gmitio/soundstage_design_workshop/Assembly/SoundstageFXPedal_V1_Assembly_BoM.xlsx

Reference | Value | Component
C201,C202 | 47uF | MOUSER: 232-63PK47MEFC6.3X11
C203,C204,C302,C303,C304,C408,C409 | 100uF | MOUSER: 232-25PX100MEFC5X11
C205,C206,C207,C305,C306,C401 | 100pF | MOUSER: 810-FG18C0G1H101JNT0
C301 | 1nF | MOUSER: 810-FG28C0G1H102JNT6
C307 | 47uF | MOUSER: 232-25PK47MEFC5X11
C402,C501 | 0.033uF | MOUSER: 810-FG14C0G1H333JNT6
C403 | 1500pF | MOUSER: 810-FG28C0G1H152JNT6
C404 | 0.22uF | MOUSER: 810-FG14X7R1H224KNT0
C405,C407,C410 | 10uF | MOUSER: 667-EEA-FC1E100
C406 | 0.015uF | MOUSER: 594-K153K15X7RF53L2
C502 | 0.047uF | MOUSER: 810-FG18X7R1H473KNT6
C701,C703 | 2.2uF | MOUSER: 667-ECA-1HM2R2
C702 | 0.01uF | MOUSER: 810-FG28C0G1H103JNT6
D101,D102 | 1N5819 | MOUSER: 637-1N5819
D301,D302 | 1N4148 | MOUSER: 512-1N4148
D401,D402 | LED | MOUSER: 606-4304H1
D403 | BAR43S | MOUSER: 511-BAR43SFILM
J101 | JST XH-B4B | MOUSER: 306-B4BXHALFSN
J102 | Barrel_Jack | MOUSER: 710-694106301002
J103 | BATT_CONN | MOUSER: 534-235
J105,J201,J202,RV301,RV401,RV402,RV501,RV502,RV701,RV702 | -- mixed values -- | MOUSER: 306-B3BXHALFSNP
J601,J602 | Conn_01x02_Pin
Q301,Q302 | 2N3906 | MOUSER: 637-2N3906
Q401 | 2N5457 | https://stompboxparts.com/semiconductors/2n5457-jfet/
Q701,Q702 | BC109 | MOUSER: 610-BC109C-TL
R201,R203,R405,R409,R506 | 10k | MOUSER: 603-MFR-25FTF52-10K
R202 | 820R | MOUSER: 603-MFR-25FBF52-820R
R204,R207 | 3.9k | MOUSER: 603-MFR-25FBF52-3K9
R205,R206 | 560R | MOUSER: 603-MFR-25FBF52-560R
R208,R301 | 3.3k | MOUSER: 603-MFR-25FRF52-3K3
R209,R210,R302,R303,R414 | 47k | MOUSER: 603-MFR-25FBF52-47K
R304,R305 | 4.7k | MOUSER: 603-MFR-25FTF52-4K7
R306,R307,R505 | 15k | MOUSER: 603-MFR-25FRF5215K
R308 | 33R | MOUSER: 603-MFR-25FBF52-33R
R309,R310,R501,R504 | 22k | MOUSER: 603-MFR-25FTF52-22K
R401,R415 | 200R | MOUSER: 603-MFR-25FBF52-200R
R402,R403,R404,R410,R412 | 1Meg | MOUSER: 603-MFR-25FTF52-1M
R406,R413 | 39k | MOUSER: 603-MFR-25FBF52-39K
R407,R411 | 22R | MOUSER: 603-MFR-25FBF52-22R
R408 | 5.1k | MOUSER: 603-MFR-25FBF52-5K1
R503 | 220k | MOUSER: 603-MFR-25FBF52-220K
R507 | 1k | MOUSER: 603-MFR-25FBF52-1K
R701 | 8.2k | MOUSER: 603-MFR-25FBF52-8K2
R702 | 330R | MOUSER: 603-MFR-25FTF52-330R
R703 | 33k | MOUSER: 603-MFR-25FBF52-33K
R704 | 100k | MOUSER: 708-RNF14FTD100K
SW201 | SW_DPDT_x2 | MOUSER: 306-B6BXHALFSN
U301,U401,U501 | TL072 | MOUSER: 595-TL072CP
