gmitio/soundstage_design_workshop/Assembly/SoundstageFXPedal_V1_Assembly_Drawing_Updated.pdf

# Assembly Drawing (Top View)

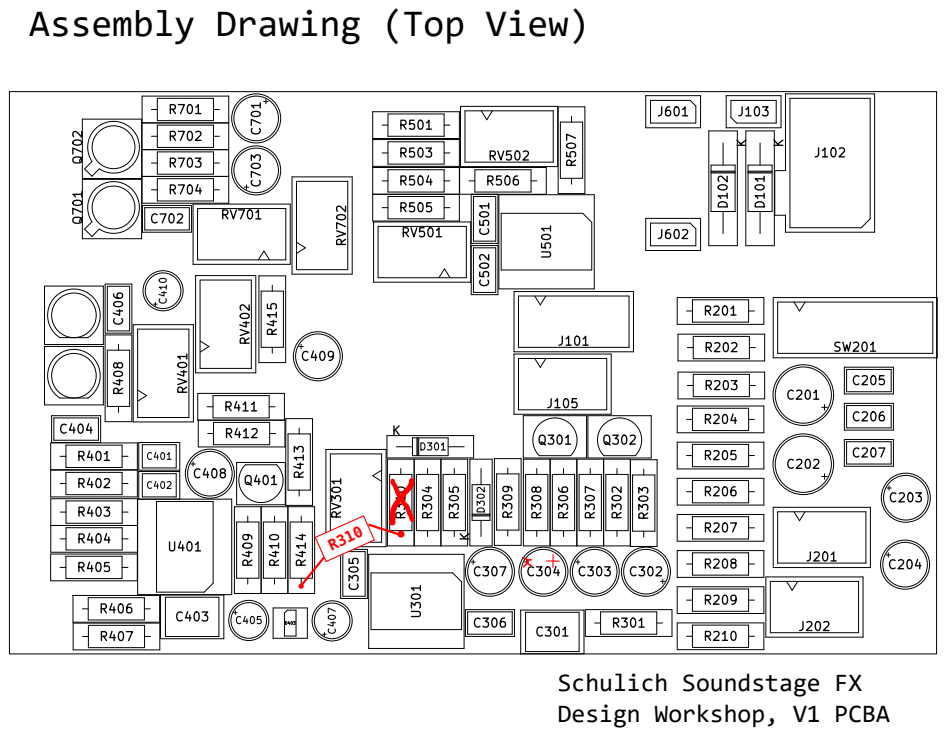
[picture p1: page 1]
