gmitio/soundstage_design_workshop/Schematic/SoundstageFXPedal_V1.pdf

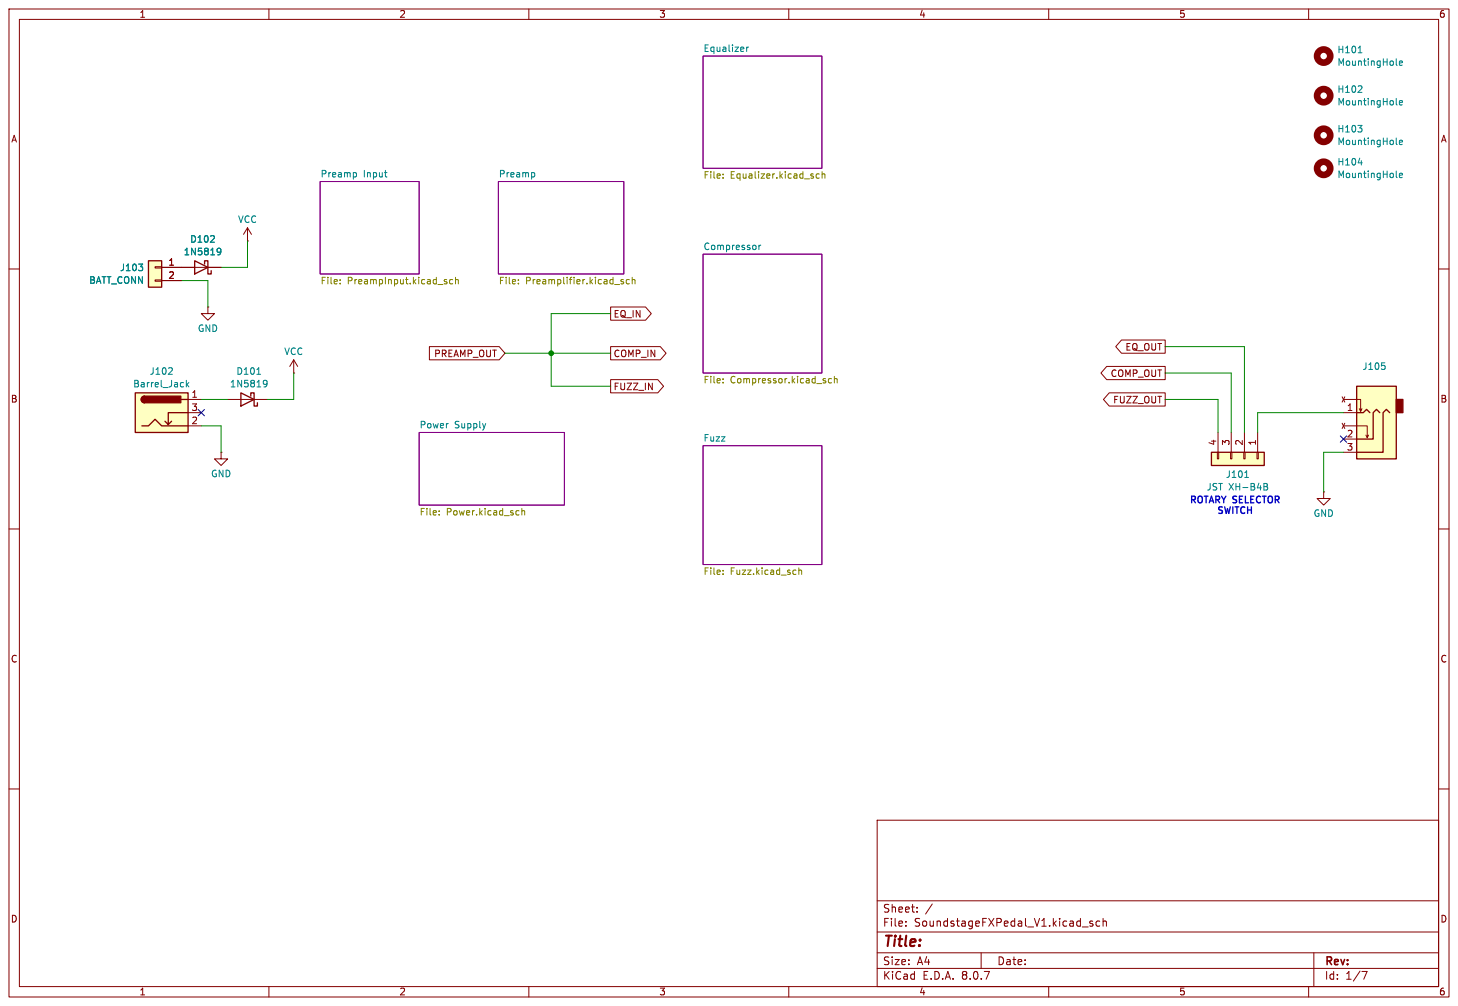
[picture p2: page 1]

J105 H102 MountingHole H101 MountingHole H103 MountingHole VCC

Compressor File: Compressor.kicad_sch Power Supply File: Power.kicad_sch Preamp File: Preamplifier.kicad_sch

Id: 1/7 Title: File: SoundstageFXPedal_V1.kicad_sch Sheet: /

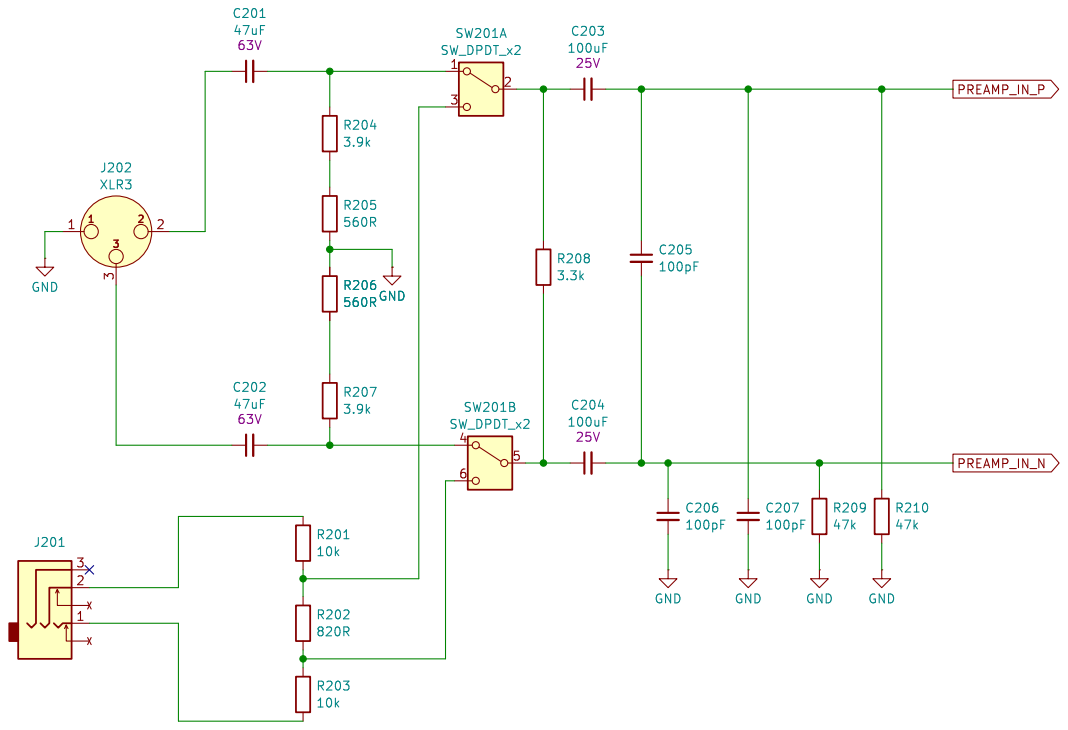
[picture p3: page 2]

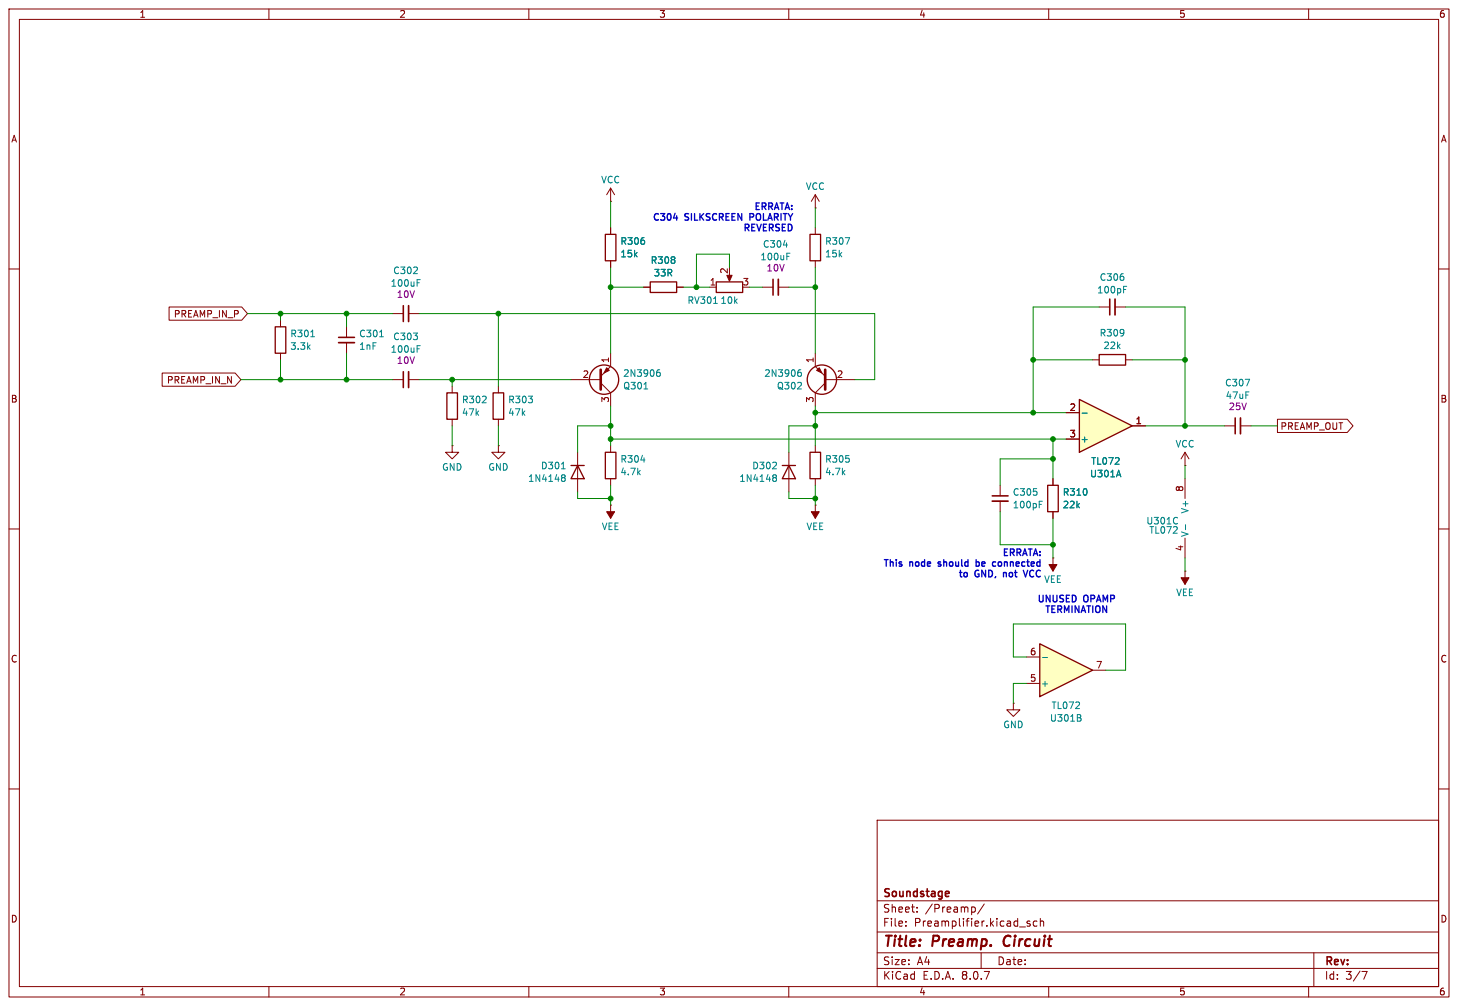
[picture p4: page 3]

ERRATA: C304 SILKSCREEN POLARITY REVERSED

PREAMP_OUT ERRATA: This node should be connected

to GND, not VCC

Id: 3/7 Title: Preamp. Circuit File: Preamplifier.kicad_sch Sheet: /Preamp/

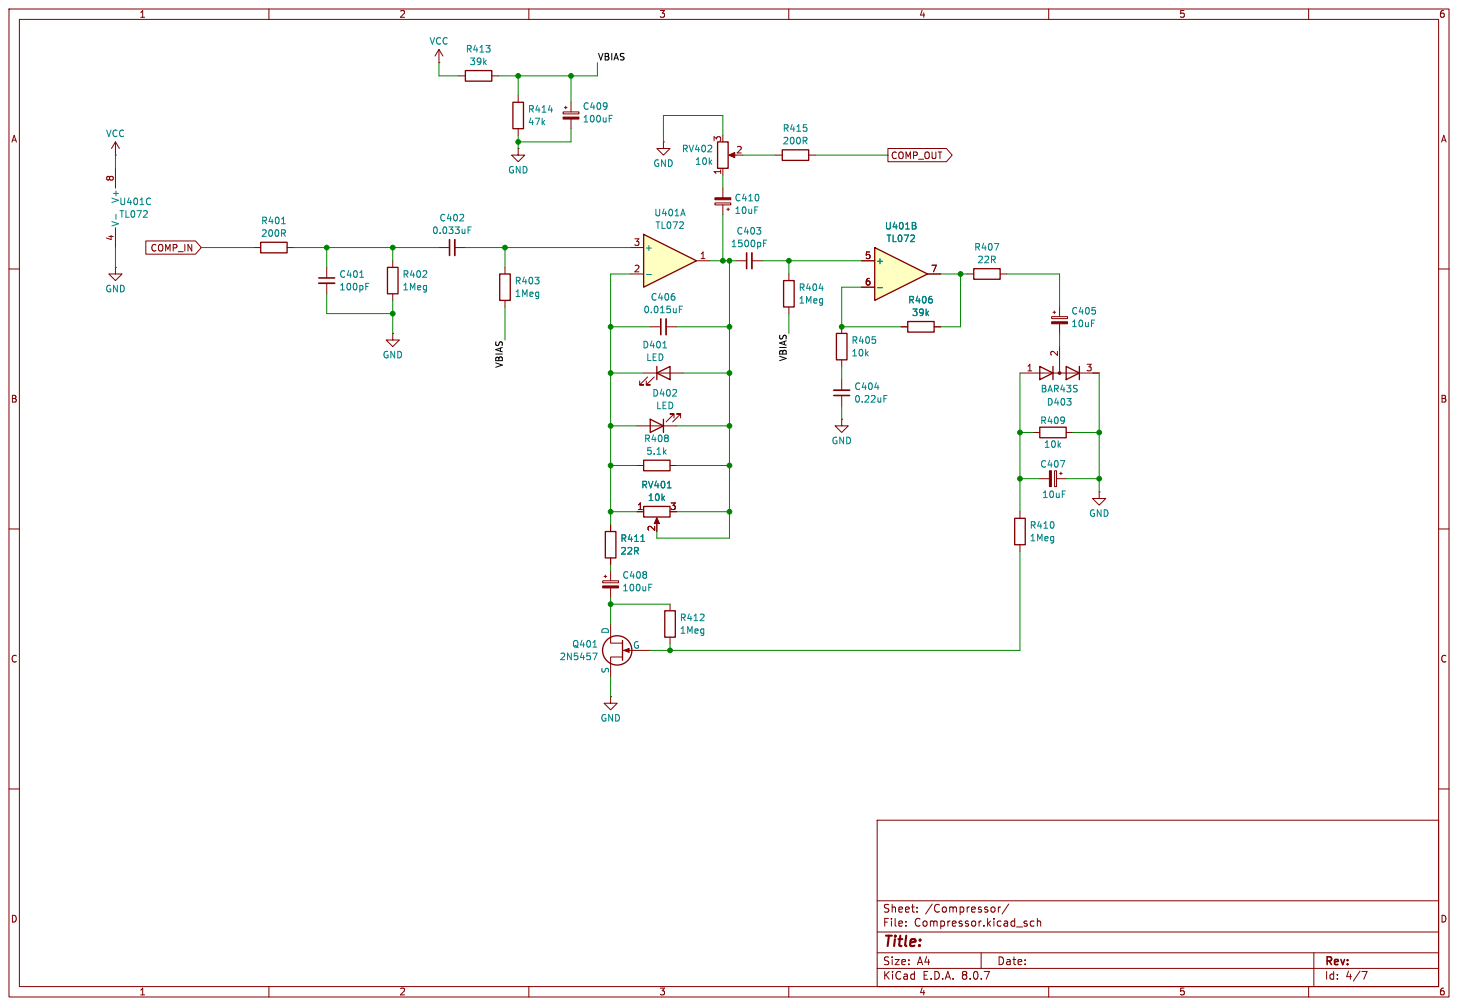
[picture p5: page 4]

Id: 4/7 Title: File: Compressor.kicad_sch Sheet: /Compressor/

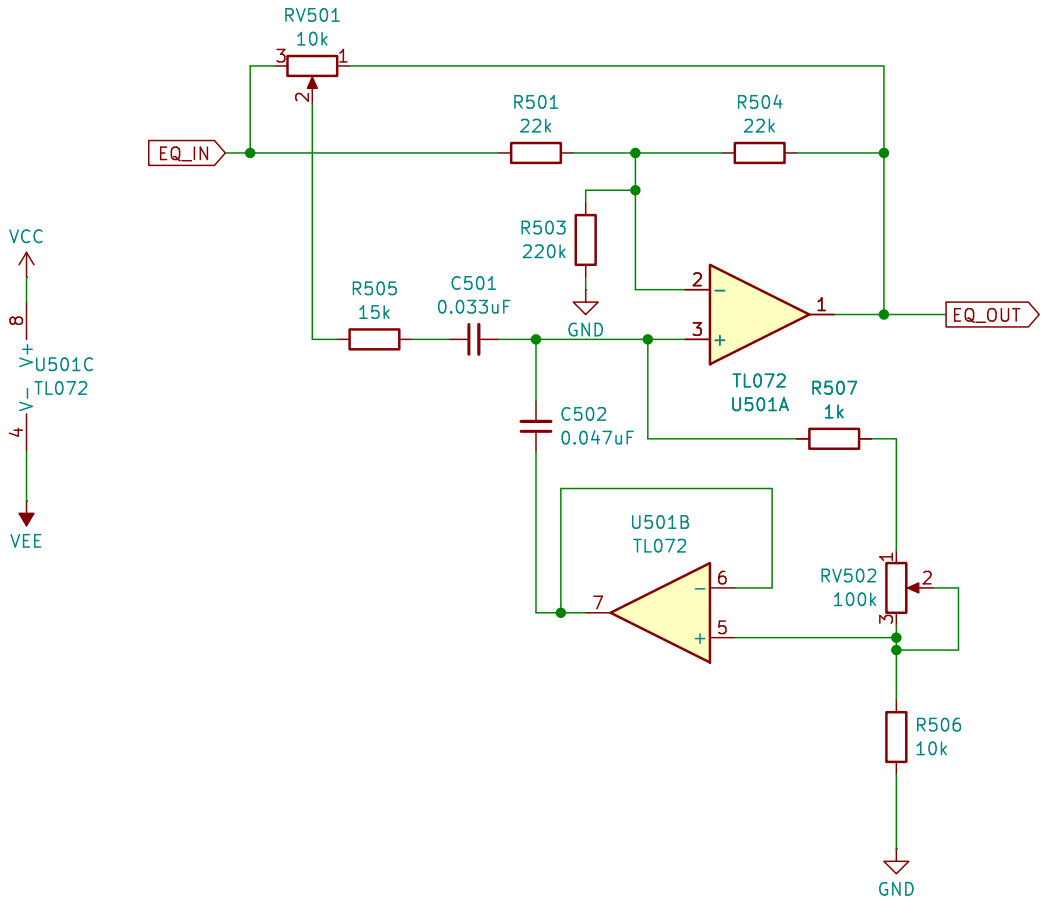
[picture p6: page 5]

Id: 5/7 Title: File: Equalizer.kicad_sch Sheet: /Equalizer/

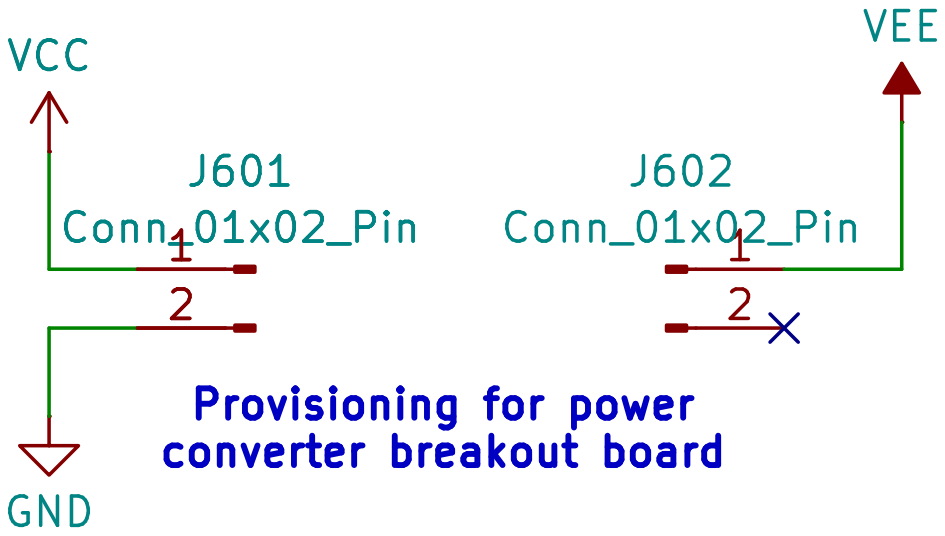
[picture p7: page 6]

J602 Conn_01x02_Pin Provisioning for power converter breakout board VCC

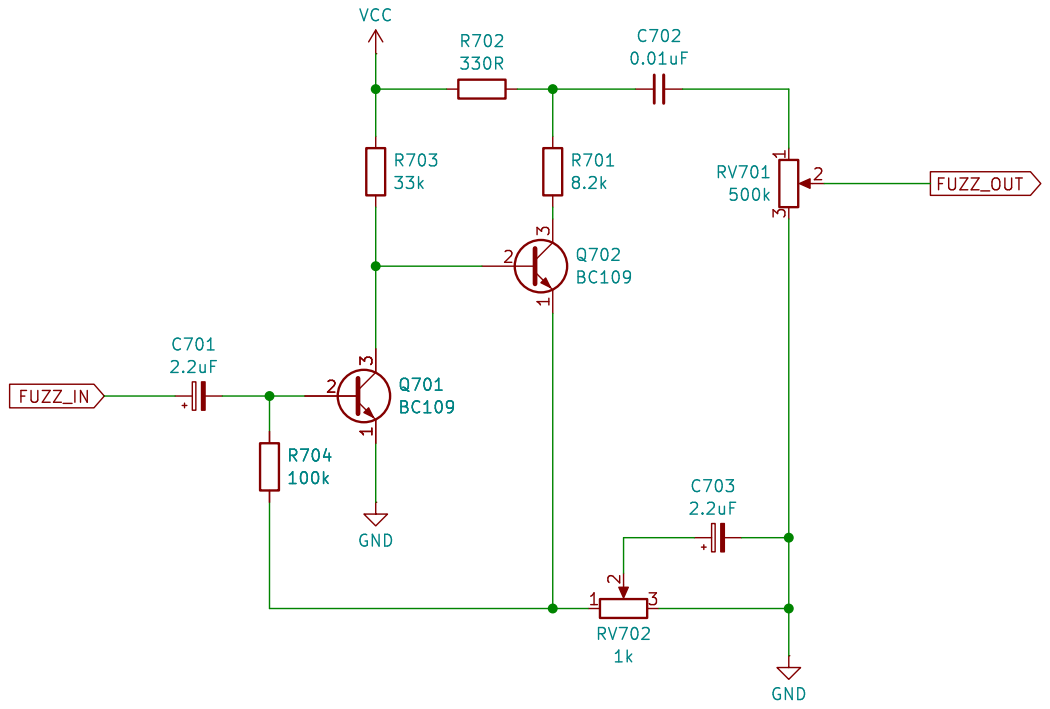
[picture p8: page 7]

Id: 7/7 Title: File: Fuzz.kicad_sch Sheet: /Fuzz/ GND
