gmitio/soundstage_design_workshop/Resources/Switchcraft_N112BPCX.pdf

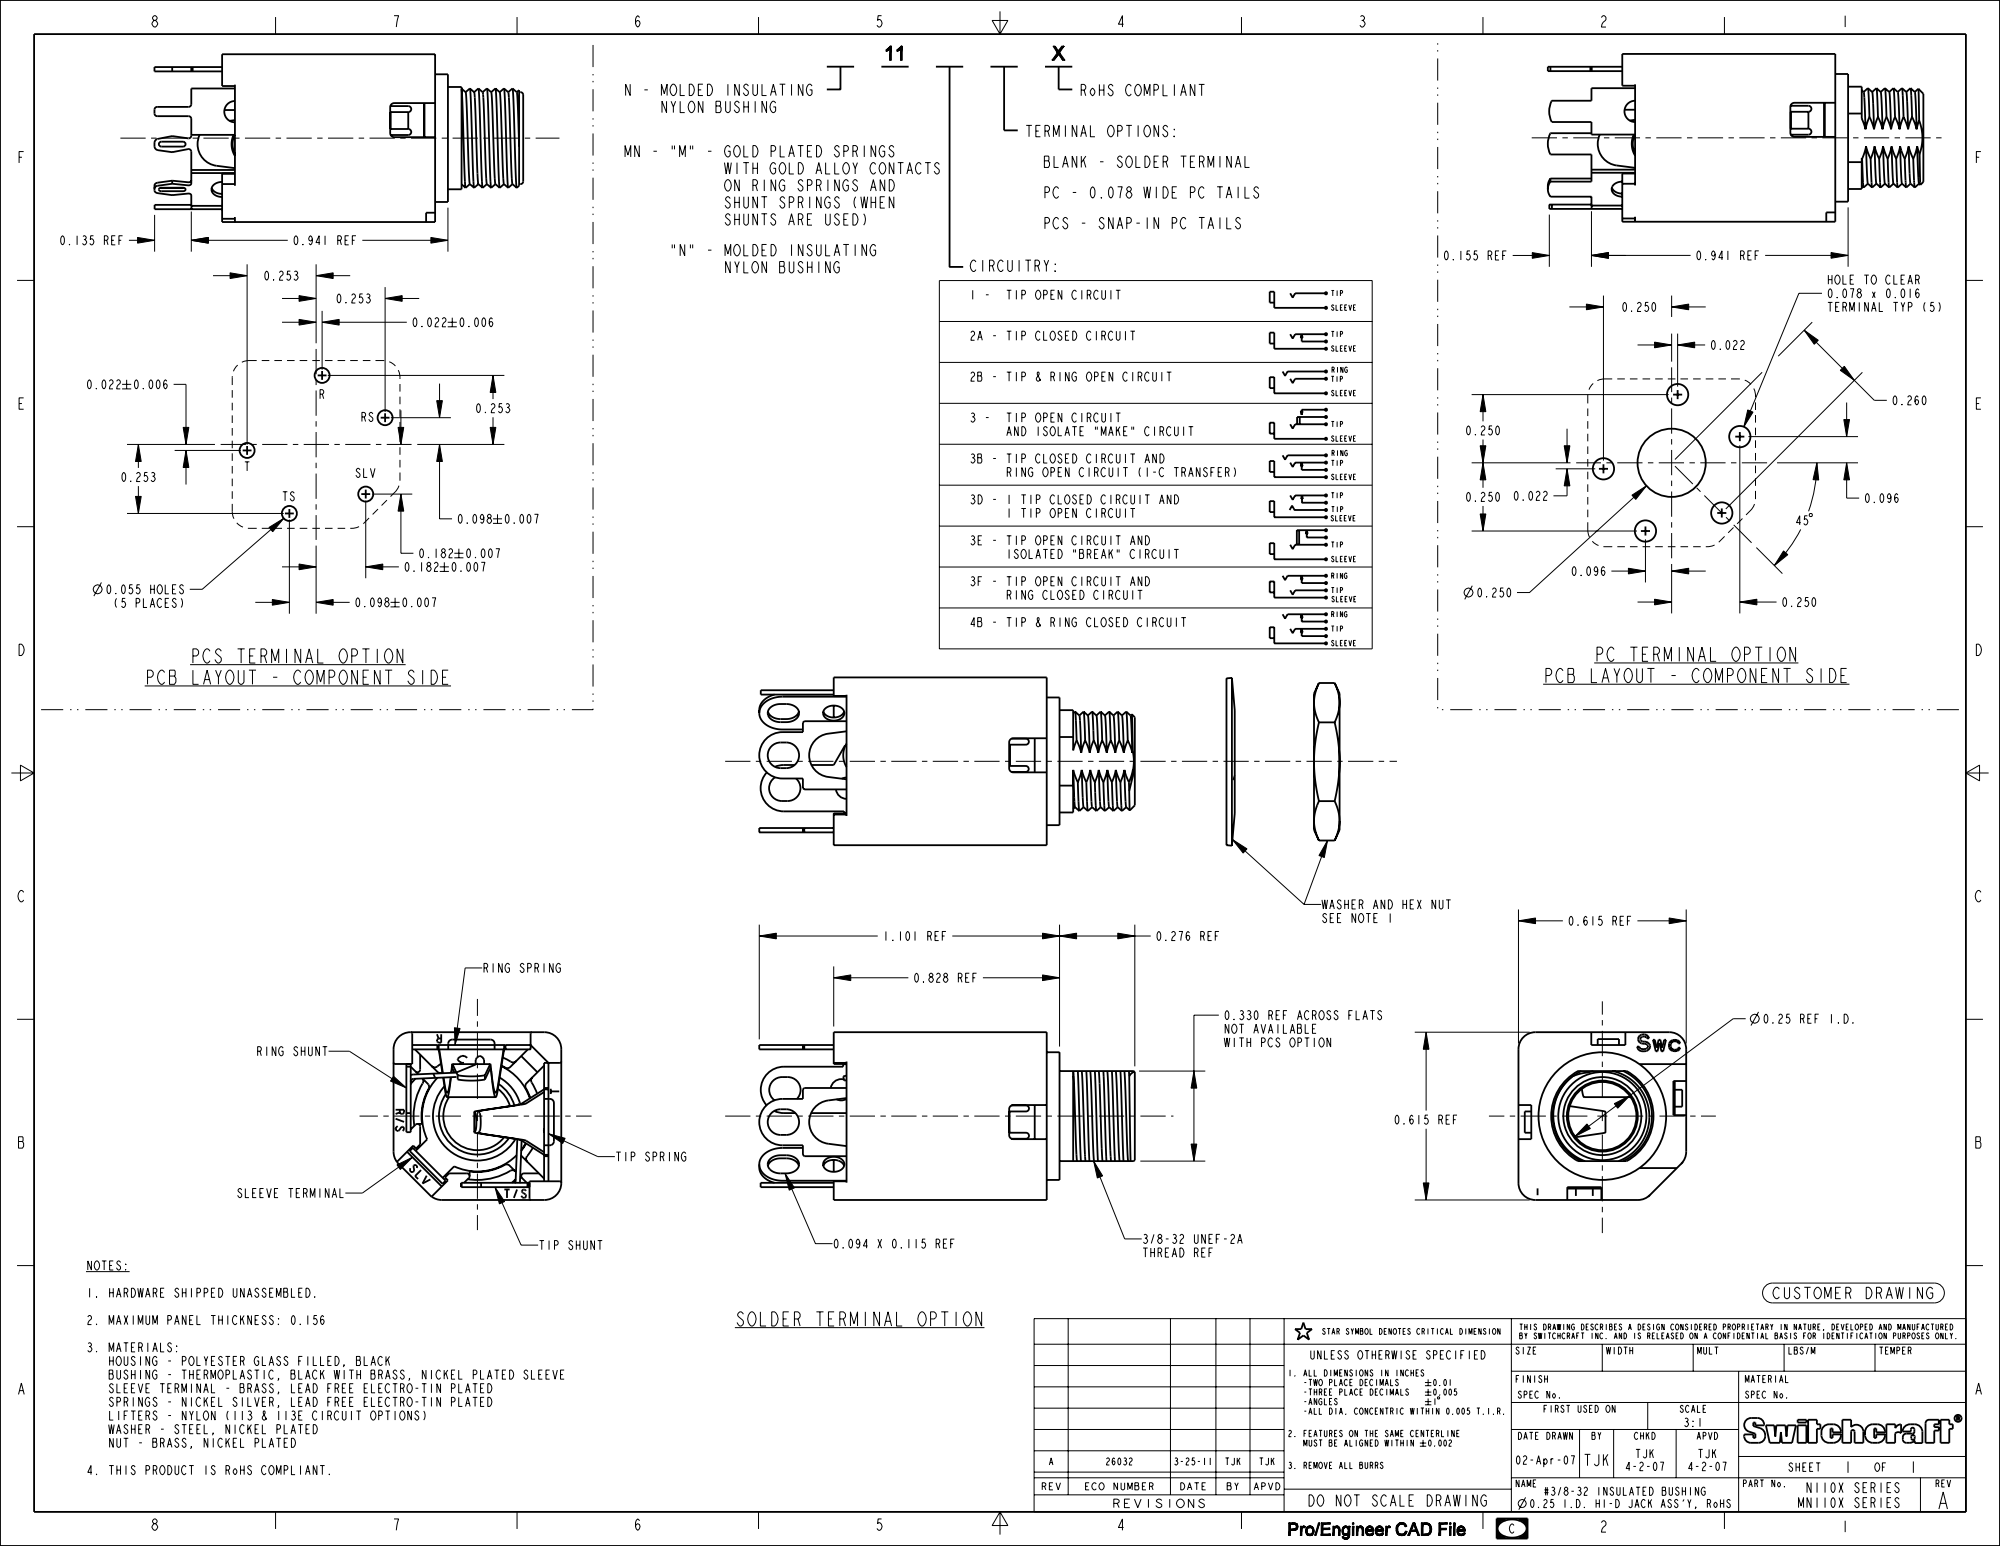
[picture p9: page 1]
