gmitio/soundstage_design_workshop/SoundstageFXPedal_V1.kicad_pcb

## KiCad design SoundstageFXPedal_V1.kicad_pcb (2025-01-26)

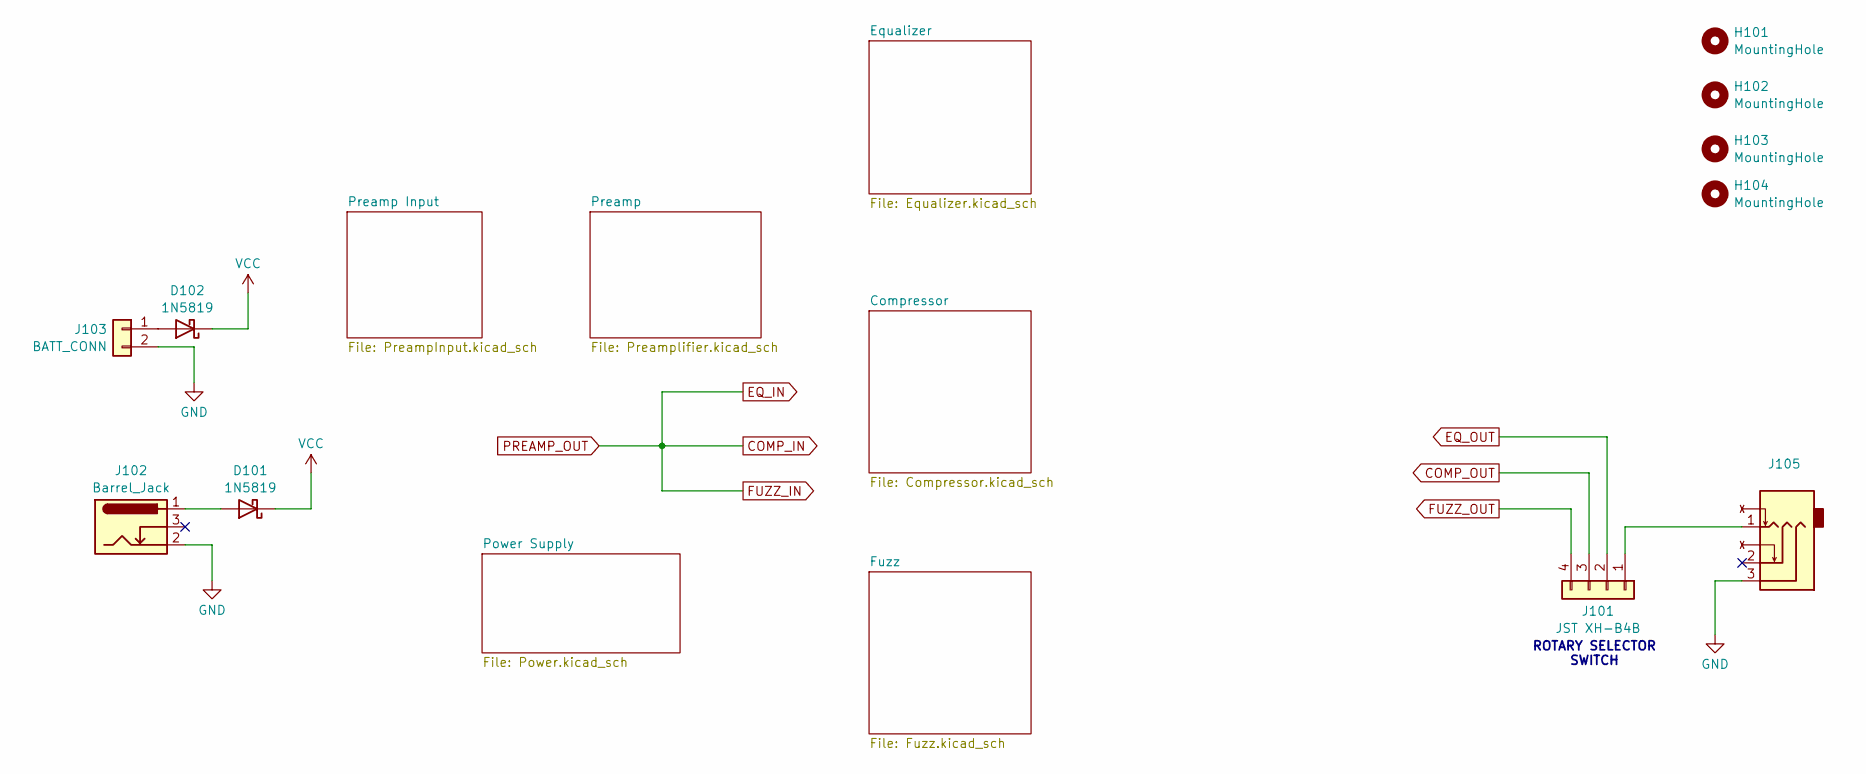
[picture p10: schematic SoundstageFXPedal_V1.kicad_sch]

Parts:
D101, D102: 1N5819; D_DO-41_SOD81_P10.16mm_Horizontal
H101, H102, H103, H104: MountingHole; MountingHole_4.3mm_M4_DIN965
J101: JST XH-B4B; JST_XH_B4B-XH-A_1x04_P2.50mm_Vertical
J102: Barrel_Jack; BarrelJack_Wuerth_6941xx301002
J103: BATT_CONN; PinHeader_1x02_P2.54mm_Vertical
J105: JST_XH_B3B-XH-A_1x03_P2.50mm_Vertical

Connections:
COMP_OUT: J101.3; also elsewhere on the board
EQ_OUT: J101.2; also elsewhere on the board
FUZZ_OUT: J101.4; also elsewhere on the board
GND: J102.2, J103.2, J105.3; also elsewhere on the board
unnamed: D101.2 (A), J102.1
unnamed: D102.2 (A), J103.1
unnamed: J101.1, J105.1
VCC: D101.1 (K), D102.1 (K); also elsewhere on the board

Notes on the sheet:
ROTARY SELECTOR SWITCH

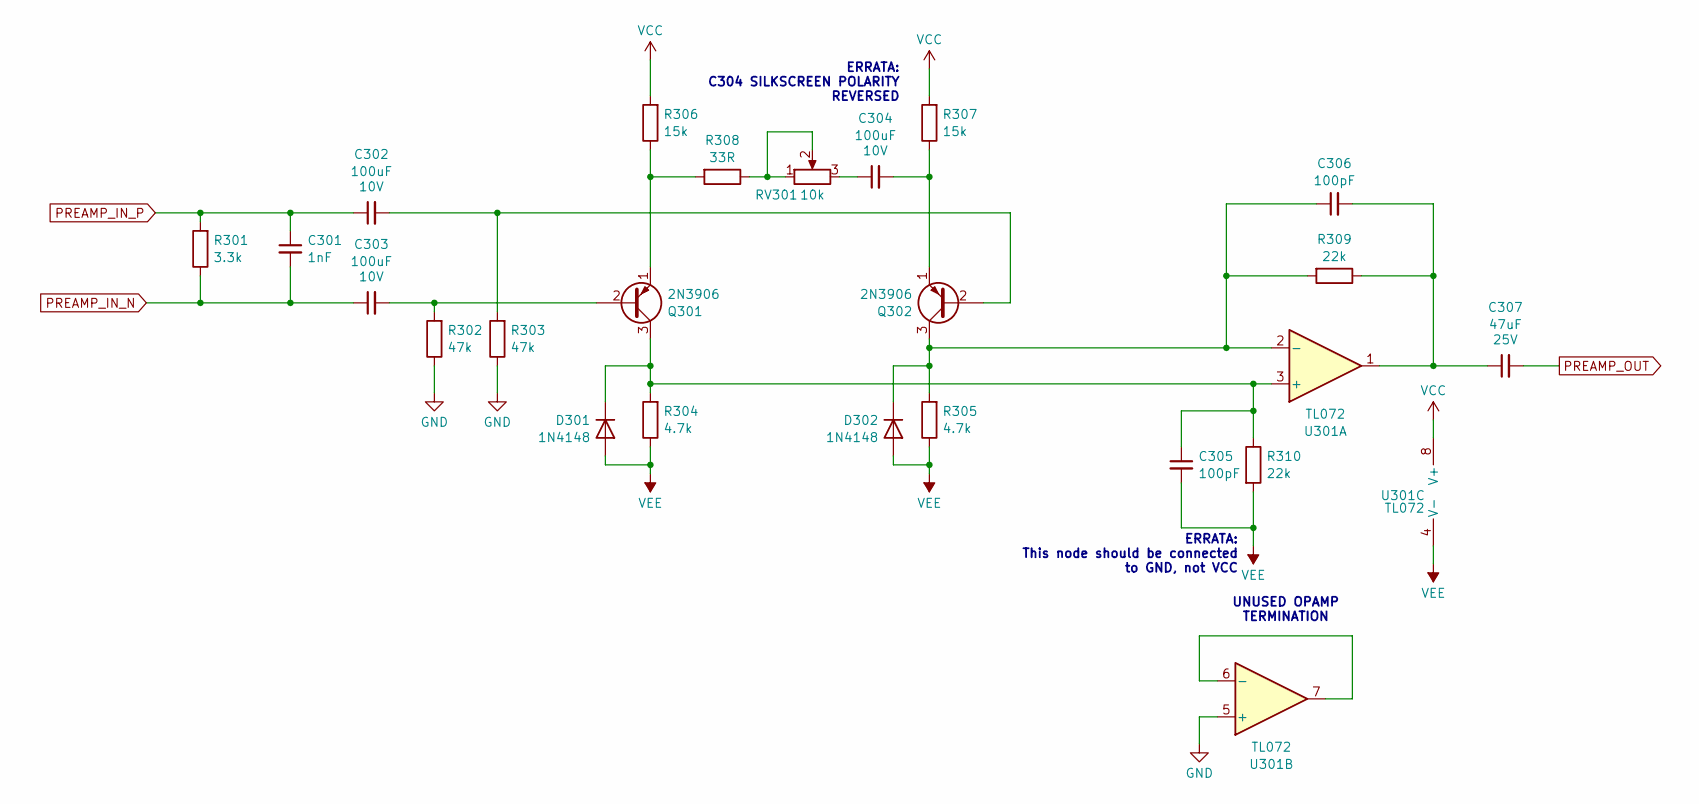
[picture p11: schematic Preamplifier.kicad_sch, Preamp. Circuit]

Parts:
C301: 1nF; C_Disc_D6.0mm_W4.4mm_P5.00mm
C302, C303, C304: 100uF; CP_Radial_D5.0mm_P2.00mm; Voltage 10V
C305, C306: 100pF; C_Disc_D5.0mm_W2.5mm_P2.50mm
C307: 47uF; CP_Radial_D5.0mm_P2.00mm; Voltage 25V; PartNo. MOUSER: 232-25PK47MEFC5X11
D301, D302: 1N4148; D_DO-35_SOD27_P7.62mm_Horizontal
Q301, Q302: 2N3906; TO-92_Inline_Wide
R301: 3.3k; R_Axial_DIN0207_L6.3mm_D2.5mm_P7.62mm_Horizontal
R302, R303: 47k; R_Axial_DIN0207_L6.3mm_D2.5mm_P7.62mm_Horizontal
R304, R305: 4.7k; R_Axial_DIN0207_L6.3mm_D2.5mm_P7.62mm_Horizontal
R306, R307: 15k; R_Axial_DIN0207_L6.3mm_D2.5mm_P7.62mm_Horizontal
R308: 33R; R_Axial_DIN0207_L6.3mm_D2.5mm_P7.62mm_Horizontal
R309, R310: 22k; R_Axial_DIN0207_L6.3mm_D2.5mm_P7.62mm_Horizontal
RV301: 10k; JST_XH_B3B-XH-A_1x03_P2.50mm_Vertical
U301: TL072; DIP-8_W7.62mm_LongPads

Connections:
GND: R302.1, R303.1, U301.5 (+); also elsewhere on the board
unnamed: C304.1, RV301.3
unnamed: C306.2, C307.1, R309.1, U301.1
unnamed: C305.1, D301.1 (K), Q301.3 (C), R304.2, R310.1, U301.3 (+)
unnamed: C306.1, D302.1 (K), Q302.3 (C), R305.2, R309.2, U301.2 (-)
unnamed: C303.2, Q301.2 (B), R302.2
unnamed: Q301.1 (E), R306.1, R308.2
unnamed: C302.2, Q302.2 (B), R303.2
unnamed: C304.2, Q302.1 (E), R307.1
unnamed: R308.1, RV301.1, RV301.2
unnamed: U301.6 (-), U301.7
PREAMP_IN_N: C301.2, C303.1, R301.1; also elsewhere on the board
PREAMP_IN_P: C301.1, C302.1, R301.2; also elsewhere on the board
VCC: R306.2, R307.2, U301.8 (V+); also elsewhere on the board
VEE: C305.2, D301.2 (A), D302.2 (A), R304.1, R305.1, R310.2, U301.4 (V-); also elsewhere on the board

Notes on the sheet:
ERRATA: This node should be connected to GND, not VCC
UNUSED OPAMP TERMINATION
ERRATA: C304 SILKSCREEN POLARITY REVERSED

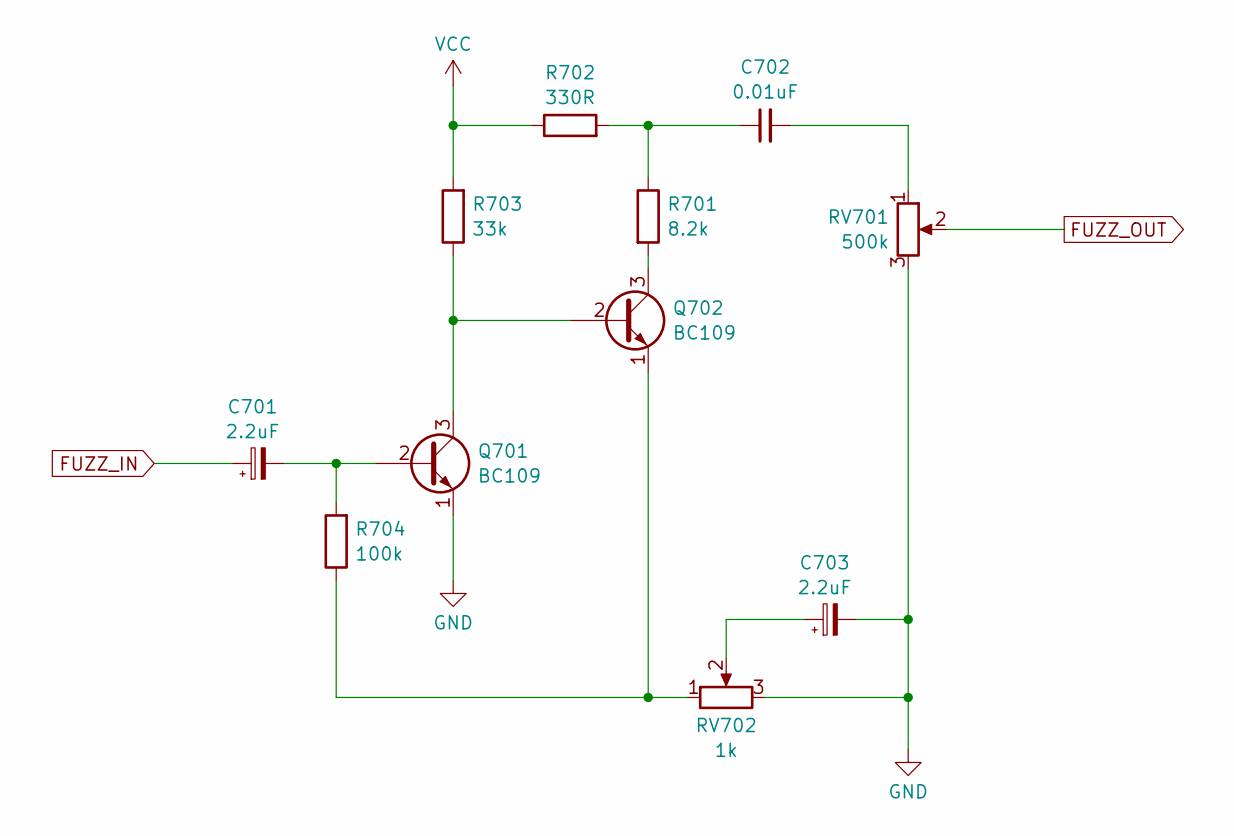
[picture p12: schematic Fuzz.kicad_sch]

Parts:
C701, C703: 2.2uF; CP_Radial_D5.0mm_P2.00mm
C702: 0.01uF; C_Disc_D5.0mm_W2.5mm_P2.50mm
Q701, Q702: BC109; TO-18-3
R701: 8.2k; R_Axial_DIN0207_L6.3mm_D2.5mm_P7.62mm_Horizontal
R702: 330R; R_Axial_DIN0207_L6.3mm_D2.5mm_P7.62mm_Horizontal
R703: 33k; R_Axial_DIN0207_L6.3mm_D2.5mm_P7.62mm_Horizontal
R704: 100k; R_Axial_DIN0207_L6.3mm_D2.5mm_P7.62mm_Horizontal
RV701: 500k; JST_XH_B3B-XH-A_1x03_P2.50mm_Vertical
RV702: 1k; JST_XH_B3B-XH-A_1x03_P2.50mm_Vertical

Connections:
FUZZ_OUT: RV701.2; also elsewhere on the board
GND: C703.2, Q701.1 (E), RV701.3, RV702.3; also elsewhere on the board
unnamed: C702.1, R701.1, R702.2
unnamed: C702.2, RV701.1
unnamed: C703.1, RV702.2
unnamed: C701.2, Q701.2 (B), R704.2
unnamed: Q701.3 (C), Q702.2 (B), R703.1
unnamed: Q702.3 (C), R701.2
unnamed: Q702.1 (E), R704.1, RV702.1
VCC: R702.1, R703.2; also elsewhere on the board

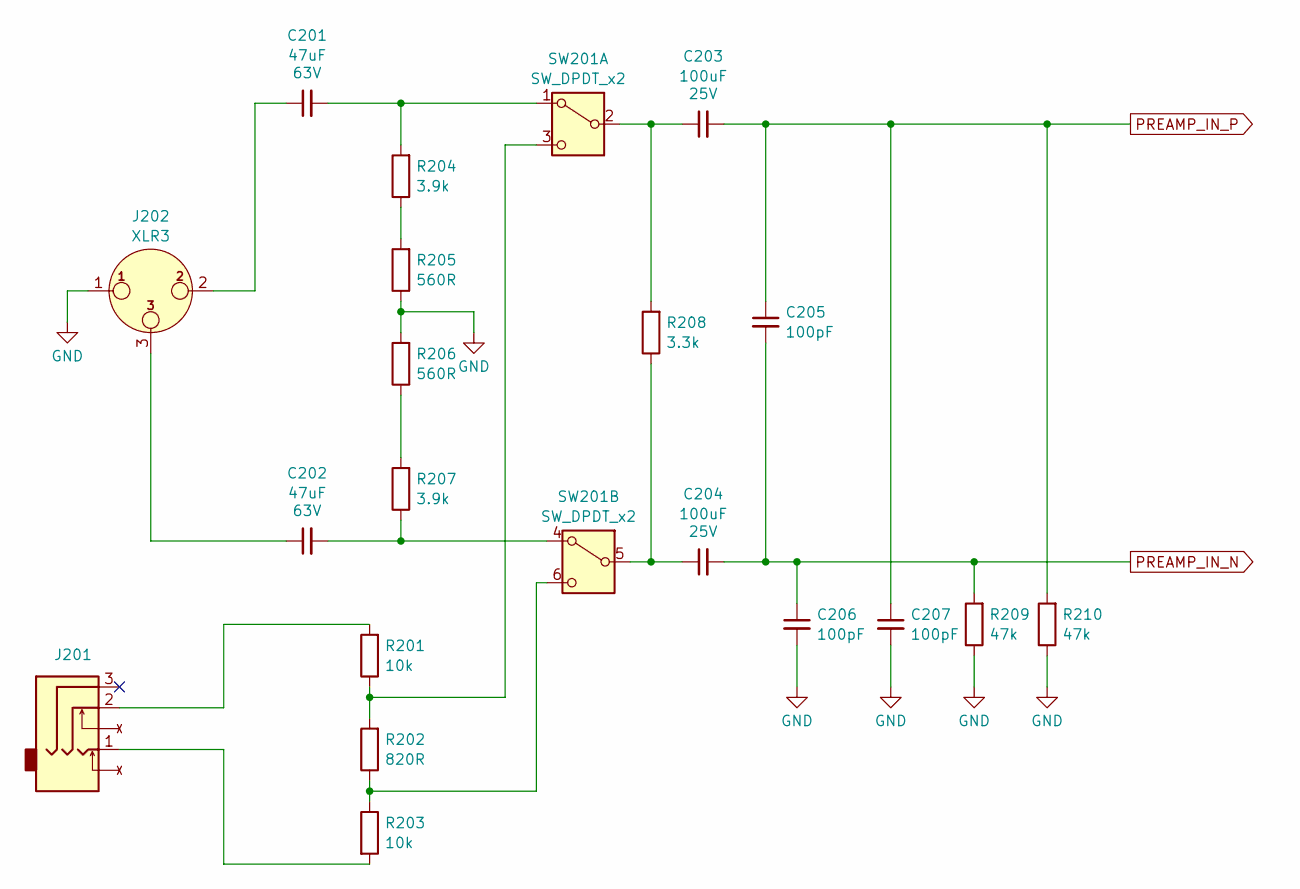
[picture p13: schematic PreampInput.kicad_sch, Preamp Input Circuit]

Parts:
C201, C202: 47uF; CP_Radial_D6.3mm_P2.50mm; Voltage 63V
C203, C204: 100uF; CP_Radial_D5.0mm_P2.00mm; Voltage 25V
C205, C206, C207: 100pF; C_Disc_D5.0mm_W2.5mm_P2.50mm
J201: JST_XH_B3B-XH-A_1x03_P2.50mm_Vertical
J202: XLR3; JST_XH_B3B-XH-A_1x03_P2.50mm_Vertical
R201, R203: 10k; R_Axial_DIN0207_L6.3mm_D2.5mm_P7.62mm_Horizontal
R202: 820R; R_Axial_DIN0207_L6.3mm_D2.5mm_P7.62mm_Horizontal
R204, R207: 3.9k; R_Axial_DIN0207_L6.3mm_D2.5mm_P7.62mm_Horizontal
R205, R206: 560R; R_Axial_DIN0207_L6.3mm_D2.5mm_P7.62mm_Horizontal
R208: 3.3k; R_Axial_DIN0207_L6.3mm_D2.5mm_P7.62mm_Horizontal
R209, R210: 47k; R_Axial_DIN0207_L6.3mm_D2.5mm_P7.62mm_Horizontal
SW201: SW_DPDT_x2; JST_XH_B6B-XH-A_1x06_P2.50mm_Vertical

Connections:
GND: C206.2, C207.2, J202.1, R205.1, R206.2, R209.1, R210.1; also elsewhere on the board
unnamed: C201.1, J202.2
unnamed: C202.1, J202.3
unnamed: J201.1, R203.2
unnamed: J201.2, R201.2
unnamed: R204.1, R205.2
unnamed: R206.1, R207.2
unnamed: C201.2, R204.2, SW201.1 (A)
unnamed: C203.1, R208.2, SW201.2 (B)
unnamed: R201.1, R202.2, SW201.3 (C)
unnamed: C202.2, R207.1, SW201.4 (A)
unnamed: C204.1, R208.1, SW201.5 (B)
unnamed: R202.1, R203.1, SW201.6 (C)
PREAMP_IN_N: C204.2, C205.2, C206.1, R209.2; also elsewhere on the board
PREAMP_IN_P: C203.2, C205.1, C207.1, R210.2; also elsewhere on the board

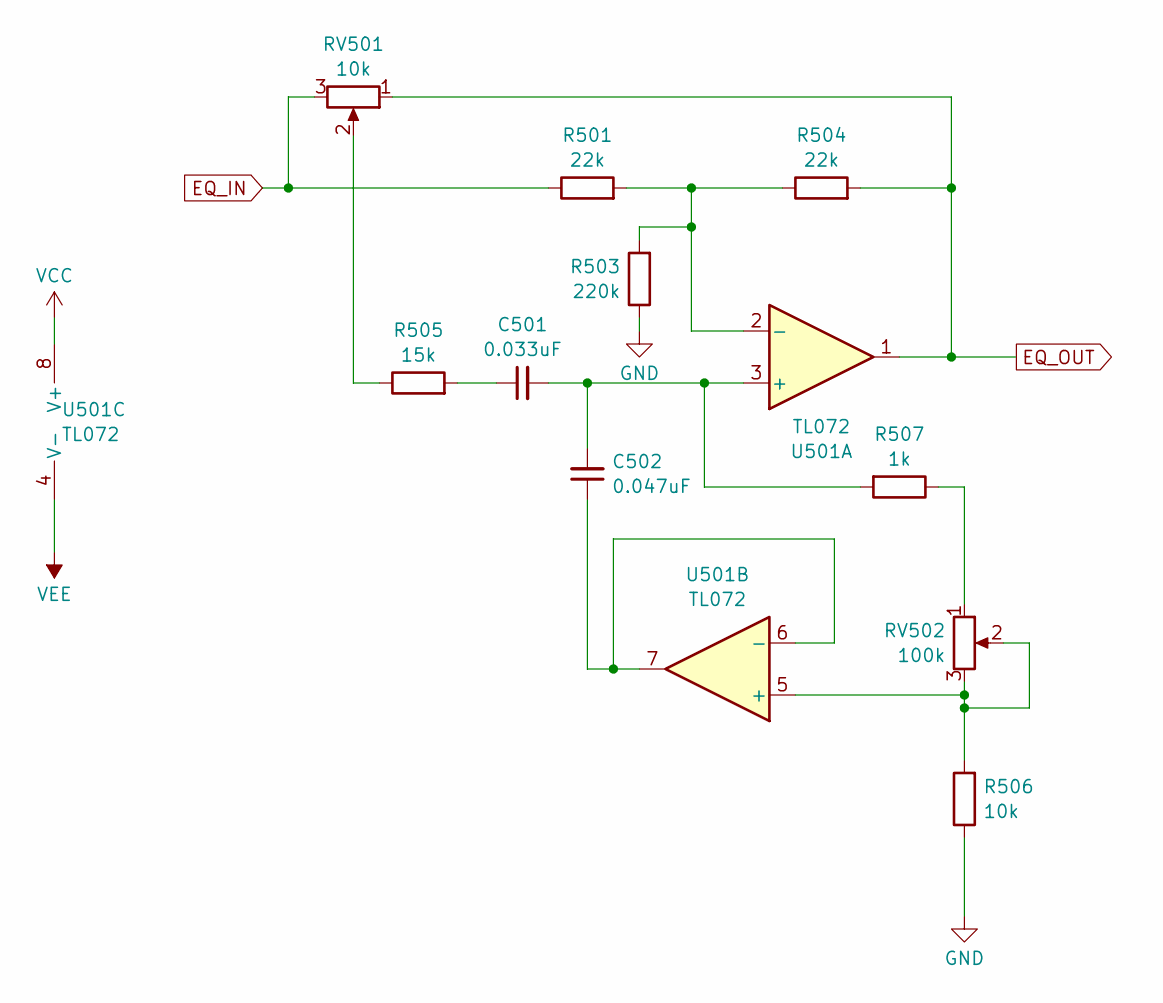
[picture p14: schematic Equalizer.kicad_sch]

Parts:
C501: 0.033uF; C_Disc_D5.0mm_W2.5mm_P2.50mm; PartNo. FG14C0G1H333JNT06
C502: 0.047uF; C_Disc_D5.0mm_W2.5mm_P2.50mm
R501, R504: 22k; R_Axial_DIN0207_L6.3mm_D2.5mm_P7.62mm_Horizontal
R503: 220k; R_Axial_DIN0207_L6.3mm_D2.5mm_P7.62mm_Horizontal
R505: 15k; R_Axial_DIN0207_L6.3mm_D2.5mm_P7.62mm_Horizontal
R506: 10k; R_Axial_DIN0207_L6.3mm_D2.5mm_P7.62mm_Horizontal
R507: 1k; R_Axial_DIN0207_L6.3mm_D2.5mm_P7.62mm_Horizontal
RV501: 10k; JST_XH_B3B-XH-A_1x03_P2.50mm_Vertical
RV502: 100k; JST_XH_B3B-XH-A_1x03_P2.50mm_Vertical
U501: TL072; DIP-8_W7.62mm_LongPads

Connections:
EQ_OUT: R504.2, RV501.1, U501.1; also elsewhere on the board
GND: R503.1, R506.1; also elsewhere on the board
unnamed: C501.1, R505.2
unnamed: R505.1, RV501.2
unnamed: R507.1, RV502.1
unnamed: C501.2, C502.2, R507.2, U501.3 (+)
unnamed: R501.2, R503.2, R504.1, U501.2 (-)
unnamed: R506.2, RV502.2, RV502.3, U501.5 (+)
unnamed: C502.1, U501.6 (-), U501.7
VCC: U501.8 (V+); also elsewhere on the board
VEE: U501.4 (V-); also elsewhere on the board

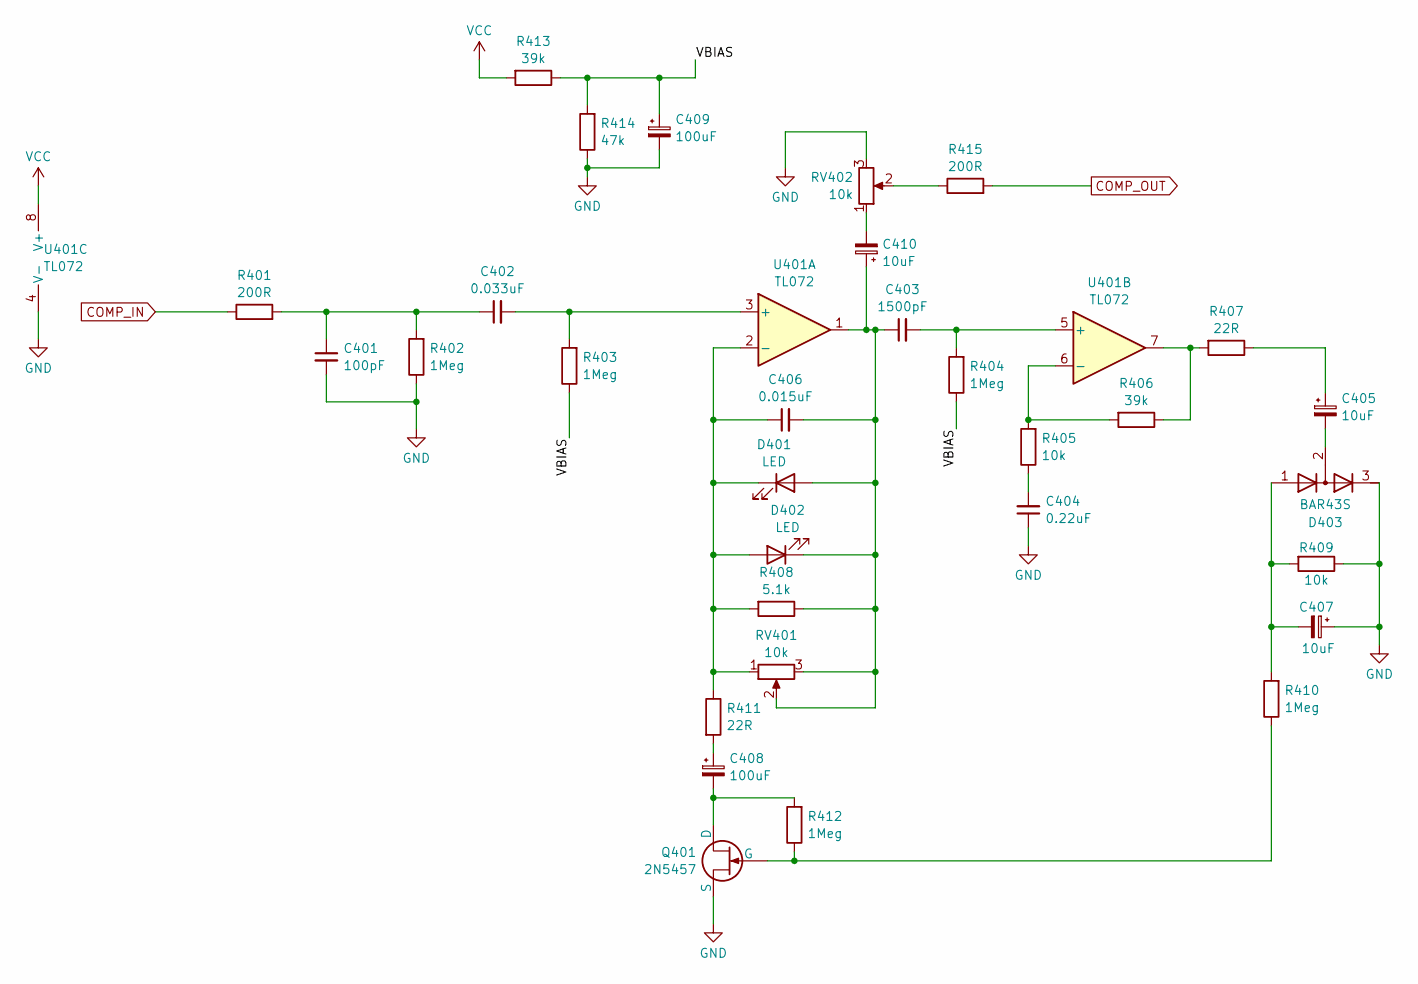
[picture p15: schematic Compressor.kicad_sch]

Parts:
C401: 100pF; C_Disc_D3.8mm_W2.6mm_P2.50mm; PartNo. FG18C0G1H101JNT06
C402: 0.033uF; C_Disc_D3.8mm_W2.6mm_P2.50mm; PartNo. FG14C0G1H333JNT06
C403: 1500pF; C_Disc_D6.0mm_W4.4mm_P5.00mm
C404: 0.22uF; C_Disc_D5.0mm_W2.5mm_P2.50mm
C405, C407, C410: 10uF; CP_Radial_D4.0mm_P1.50mm
C406: 0.015uF; C_Disc_D5.0mm_W2.5mm_P2.50mm
C408, C409: 100uF; CP_Radial_D5.0mm_P2.00mm
D401, D402: LED; LED_D5.0mm_FlatTop
D403: BAR43S; SOT-23; PartNo. BAR43SFILM
Q401: 2N5457; TO-92_Inline
R401, R415: 200R; R_Axial_DIN0207_L6.3mm_D2.5mm_P7.62mm_Horizontal
R402, R403, R404, R410, R412: 1Meg; R_Axial_DIN0207_L6.3mm_D2.5mm_P7.62mm_Horizontal
R405, R409: 10k; R_Axial_DIN0207_L6.3mm_D2.5mm_P7.62mm_Horizontal
R406, R413: 39k; R_Axial_DIN0207_L6.3mm_D2.5mm_P7.62mm_Horizontal
R407, R411: 22R; R_Axial_DIN0207_L6.3mm_D2.5mm_P7.62mm_Horizontal
R408: 5.1k; R_Axial_DIN0207_L6.3mm_D2.5mm_P7.62mm_Horizontal
R414: 47k; R_Axial_DIN0207_L6.3mm_D2.5mm_P7.62mm_Horizontal
RV401, RV402: 10k; JST_XH_B3B-XH-A_1x03_P2.50mm_Vertical
U401: TL072; DIP-8_W7.62mm_LongPads

Connections:
/Compressor/VBIAS: C409.1, R403.1, R404.1, R413.1, R414.2
COMP_OUT: R415.2; also elsewhere on the board
GND: C401.2, C404.1, C407.1, C409.2, D403.3 (K), Q401.3 (S), R402.1, R409.1, R414.1, RV402.3, U401.4 (V-); also elsewhere on the board
unnamed: C401.1, C402.1, R401.2, R402.2
unnamed: C404.2, R405.1
unnamed: C405.1, R407.1
unnamed: C405.2, D403.2
unnamed: C408.1, R411.2
unnamed: C410.2, RV402.1
unnamed: C403.1, C406.2, C410.1, D401.2 (A), D402.1 (K), R408.1, RV401.2, RV401.3, U401.1
unnamed: C406.1, D401.1 (K), D402.2 (A), R408.2, R411.1, RV401.1, U401.2 (-)
unnamed: C407.2, D403.1 (A), R409.2, R410.2
unnamed: C408.2, Q401.1 (D), R412.2
unnamed: Q401.2 (G), R410.1, R412.1
unnamed: R406.1, R407.2, U401.7
unnamed: R415.1, RV402.2
unnamed: C402.2, R403.2, U401.3 (+)
unnamed: C403.2, R404.2, U401.5 (+)
unnamed: R405.2, R406.2, U401.6 (-)
VCC: R413.2, U401.8 (V+); also elsewhere on the board

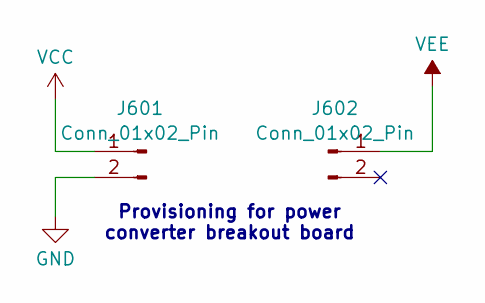
[picture p16: schematic Power.kicad_sch]

Parts:
J601, J602: Conn_01x02_Pin; PinHeader_1x02_P2.54mm_Vertical

Connections:
GND: J601.2; also elsewhere on the board
VCC: J601.1; also elsewhere on the board
VEE: J602.1; also elsewhere on the board

Notes on the sheet:
Provisioning for power converter breakout board

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
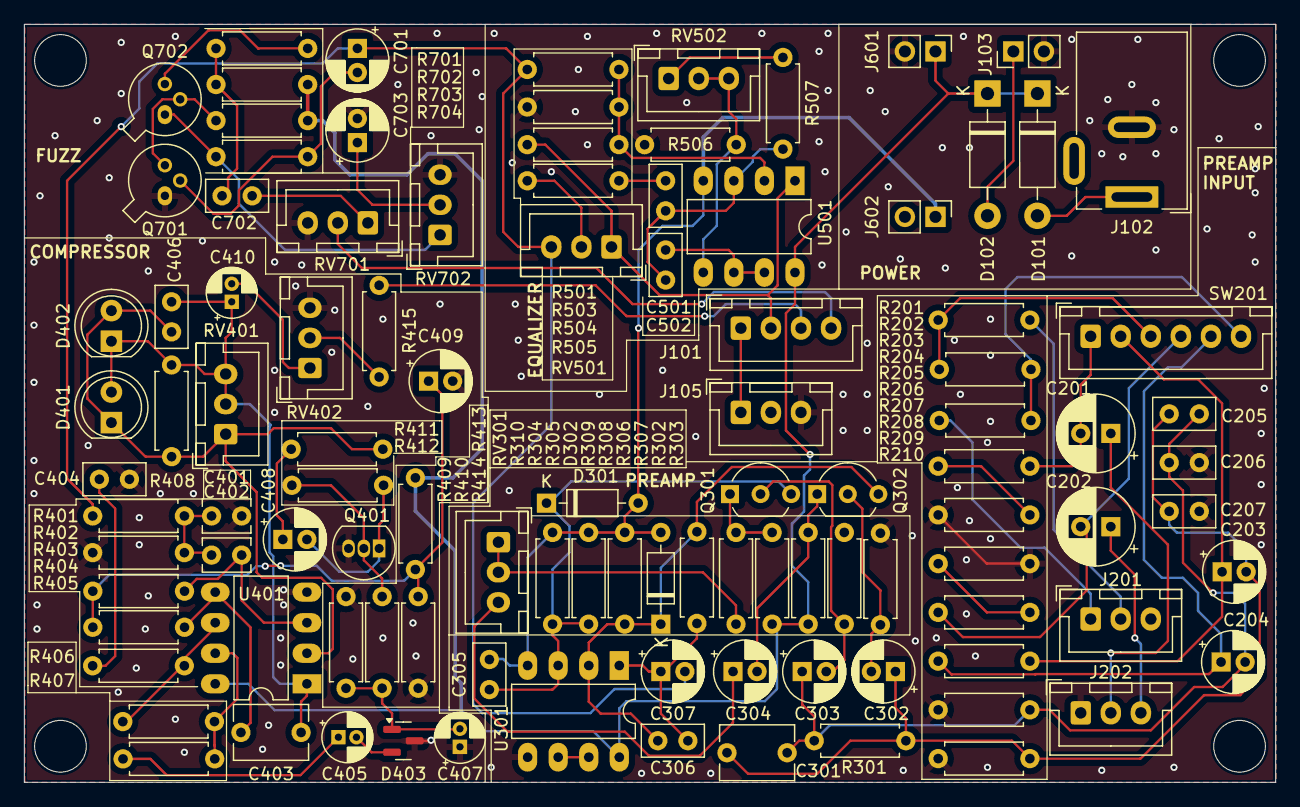
[picture p17: board SoundstageFXPedal_V1.kicad_pcb from above]

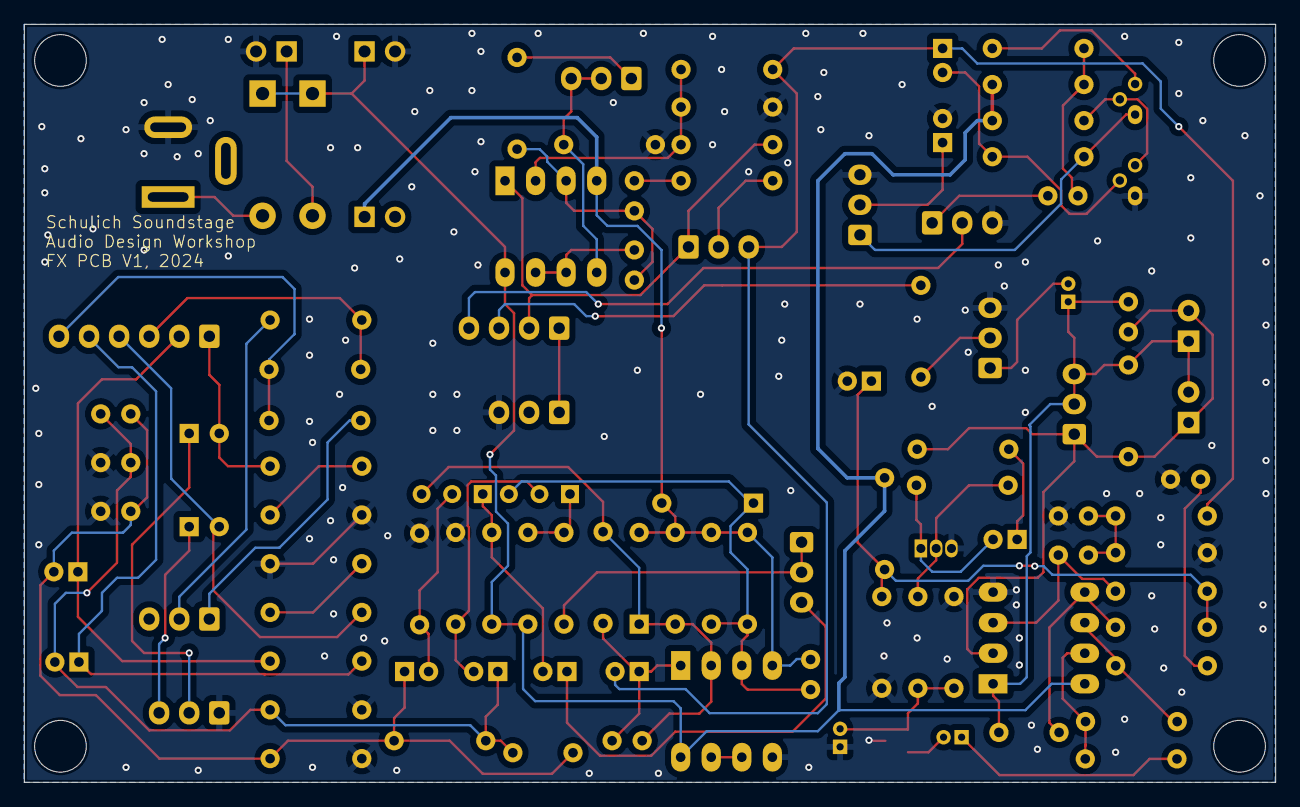
[picture p18: board SoundstageFXPedal_V1.kicad_pcb from below]

Board: 2 copper layers, 104.0 x 63.0 mm, 109 parts (4 on the bottom side), 65 nets.
