gmitio/soundstage_design_workshop/(commit log)

2024-12-13 Initial commit of Soundstage FX HW Design
    [Compressor.kicad_sch, Equalizer.kicad_sch, Fuzz.kicad_sch, Power.kicad_sch, PreampInput.kicad_sch, Preamplifier.kicad_sch, SoundstageFXPedal_V1.kicad_pcb, SoundstageFXPedal_V1.kicad_sch]
2024-12-17 Completed routing, cleanup, and artwork export
    [PreampInput.kicad_sch, Preamplifier.kicad_sch, SoundstageFXPedal_V1.kicad_pcb]
2025-01-26 Added schematic, assembly drawings, and assembly BoM exports
    [Compressor.kicad_sch, Equalizer.kicad_sch, Fuzz.kicad_sch, Power.kicad_sch, PreampInput.kicad_sch, Preamplifier.kicad_sch, SoundstageFXPedal_V1.kicad_pcb, SoundstageFXPedal_V1_Assembly_BoM.xlsx]
